XasWorks/XasCode/README.md

# XasCode allround libraries



This repository is constructed for all various libraries, be it made for OpenSCAD, AVR, or other systems, that are used for any XasWorks projects.

Currently included systems are:
- An OpenSCAD library
- An AVR Library for the ATMega328P or similar
