XasWorks/XasCode/ESP32/OneShot125/CMakeList.txt

idf_component_register(SRCS "BLDCHandler.cpp" "DShot.cpp" "OneShot125.cpp" "QuadrPropeller.cpp"
                       INCLUDE_DIRS "include")
