XasWorks/XasCode/(threads)

Thread 3 (2016-10-15):

Redo the Stepper-Motor (and some other) inheritance constructor calls.

Xasin, 2016-10-15:
Right now I'm just tricking the darn things by having a fake variable.
Ensure that they instead use constructors properly.

Xasin, 2016-10-16:
Checked:
The proper way of calling the constructor is by using
"ClassName(variables) : InheritedConstructorToBeUsed(variables) {
 }"

Simple!

Closed 2016-10-17.

Thread 16 (2017-07-17):

Improvement of the IR Code by use of ICP1 Capture Pin

Xasin, 2017-07-17:
By using the timestamp capture that the ICP1 pin provides, it would be possible to auto-adjust the timing of the IR receive ISR in order to automagically read in the data in the exact middle of the waveform.

- [x] The Timer1 ISR has to be adjusted to: OCR1A top, COMP1B_vect, so that ICR1 can still be used.
- [x] The INPUT_CAPTURE1_vect ISR has to be added
- [x] The state-machine has to be modified to remove the in-software waveform adjustment, and instead utilise the capture ISR for this.

@A-Bielefeld, I'm adding you to this so you can tag along with how these things get done >:D

Xasin, 2017-07-30:
Whelp, for now the code was moved to the LZRTag project exclusively, so it sort-of is closed ...
But an overhaul of this one here is presumably a good idea too.

Closed 2017-07-30.

Thread 32 (2019-10-23):

Fix awkward MQTT sub/pub behavior

Xasin, 2019-10-23:
Something is weird - the MQTT libraries seem to hang with their first connection for a while, before suddenly pushing out everything. Could be an artefact from not properly running the publish thread after a successful reconnect.

Xasin, 2019-10-29:
Push thread performance was improved by simply adding a "sleep" for automatic retries, and with the improved logging, debugging this should be perfectly fine!

Closed 2019-10-29.
