XasWorks/XasCode/AVR/Actuators/Steppers/X2Stepper.h

/*
 * X2Stepper.h
 *
 *  Created on: 24.10.2016
 *      Author: xasin
 */

#ifndef AVR_ACTUATORS_STEPPERS_X2STEPPER_H_
#define AVR_ACTUATORS_STEPPERS_X2STEPPER_H_

#include "PrimitiveStepper.h"
#include "../../Movement/X2/X2-Actuator.h"


namespace X2 {

class Stepper: private PrimitiveStepper, public Actuator {
private:
	// Constants for calculating how many steps the system has to do for forwards/backwards movement, as well as rotation.
	float const stepsPerMM, stepsPerDeg;

public:
	using PrimitiveStepper::update;

	// Main constructor, initializes values.
	Stepper(volatile uint8_t *P, uint8_t pins, uint8_t pind,
			uint16_t CPISR, float stepsPerMM, float stepsPerDeg);

	void ISRStepBy(float x, float r);
};

} /* namespace X2 */

#endif /* AVR_ACTUATORS_STEPPERS_X2STEPPER_H_ */
