XasWorks/XasCode/ESP32/XaI2C/LSM6DS3.cpp

/*
 * LSM6DS3.cpp
 *
 *  Created on: 1 May 2019
 *      Author: XNM
 */

#include "xnm/i2c/LSM6DS3.h"

#define LOG_LOCAL_LEVEL ESP_LOG_DEBUG
#include "esp_log.h"

namespace XNM {
namespace I2C {

LSM6DS3::LSM6DS3(uint8_t address)
	: 	maxGReading(0), maxDPSReading(0),
		axes(),
		isInitialized(false),
		addr(address) {

}

esp_err_t LSM6DS3::send_cmd(uint8_t cmd, uint8_t value) {
	auto i2c = MasterAction(addr);
	i2c.write(cmd, &value, 1);
	return i2c.execute();
}

#define CHECK_ERR(statement) do {auto r = statement; if(r != ESP_OK) {ret = r;}} while(false)
void LSM6DS3::init() {
	uint8_t FS_XLs[] = {0, 2, 3, 1};

	esp_err_t ret = ESP_OK;

	CHECK_ERR(send_cmd(CTRL1_XL, 0b01100011 | (FS_XLs[maxGReading] << 2)));

	CHECK_ERR(send_cmd(CTRL2_G, 0b01000000 | (maxDPSReading << 2)));
	CHECK_ERR(send_cmd(CTRL7_G, 0b01000000));	// Enable Highpass at 0.0324Hz

	CHECK_ERR(send_cmd(CTRL3, 0b00110100));	// INT pins Active Low & OD

	CHECK_ERR(send_cmd(CTRL10, 0b00111100));	// Enable extra functions

	CHECK_ERR(send_cmd(TAP_CFG, 0b00001111)); // Enable tap detection XYZ
	CHECK_ERR(send_cmd(TAP_THR, 0b001<<5 | 17));

	CHECK_ERR(send_cmd(0x5B, 0b1<<7));

	CHECK_ERR(send_cmd(0x5A, 0b00111111));

	if(ret != ESP_OK) {
		ESP_LOGE("LSM6DS3", "Failed to initialize %0X. Error: %s", addr, esp_err_to_name(ret));
	}
	else
		ESP_LOGI("LSM6DS3", "Finished init of %0X", addr);

	isInitialized = true;
}

float LSM6DS3::operator [](uint8_t id) {
	if(id >= 6)
		return 0;

	return axes[id];
}

void LSM6DS3::set_g_max(uint8_t num) {
	if(num == maxGReading)
		return;

	maxGReading = num;

	if(isInitialized) {
		uint8_t FS_XLs[] = {0, 2, 3, 1};
		send_cmd(CTRL1_XL, 0b01000011 | (FS_XLs[maxGReading] << 2));
	}
}

void LSM6DS3::set_dps_max(uint8_t num) {
	if(num == maxDPSReading)
		return;

	maxDPSReading = num;

	if(isInitialized)
		send_cmd(CTRL2_G, 0b01000000 | (maxDPSReading << 2));
}

void LSM6DS3::update() {
	int16_t bufferAxis[6] = {};

	auto i2c = MasterAction(addr);
	i2c.read(OUTX_L_G, bufferAxis, sizeof(bufferAxis));
	i2c.execute();

	float gMax[] = {2, 4, 8, 16};
	float DPSMax[] = {250, 500, 1000, 2000};
	
	for(uint8_t i=0; i<3; i++) {
		axes[i] = (bufferAxis[3+i]*gMax[maxGReading])/32767.0F;
		axes[3+i] = (bufferAxis[i]*DPSMax[maxDPSReading])/32767.0F;
	}
}

tap_src_t LSM6DS3::get_tap() {
	tap_src_t tap_reg = {};
	
	auto i2c = MasterAction(addr);
	i2c.read(TAP_SRC, &tap_reg, 1);
	i2c.execute();

	if(tap_reg.tapDetect || tap_reg.singleTap) {
		ESP_LOGD("LSM6DS3", "Tap data is: %c (Axis %d, dir %c, type %c)",
		tap_reg.tapDetect ? 'Y' : 'N', tap_reg.tapAxis, 
		tap_reg.tapDir ? '+' : '-', 
		tap_reg.doubleTap ? 'D' : 'S'
		);
	}

	return tap_reg;
}

} /* namespace I2C */
} /* namespace XNM */
