XasWorks/XasCode/STM32F4/NeoController/AnimationStep.cpp

/*
 * AnimationStep.cpp
 *
 *  Created on: 3 Mar 2020
 *      Author: xasin
 */

//
//AnimationStep::AnimationStep(const char *descriptor) {
//	auto first_id = AnimatorSource::decode_value_target(descriptor);
//	ID.uniq_id = first_id.ID.uniq_id;
//
//	if(ID.uniq_id == 0)
//		return;
//
//	const char * process_ptr = strpbrk(descriptor, ":");
//	if(process_ptr++ == nullptr)
//		return;
//	select_type(process_ptr);
//
//	for(int i=0; i<3; i++) {
//		process_ptr = strpbrk(process_ptr, ",");
//		if(process_ptr++ == nullptr)
//			return;
//		set_float_value(i, process_ptr);
//	}
//}
//
//void AnimationStep::select_type(const char *type_ptr) {
//	const char * const type_designators[] = {
//		"+",
//		"-",
//		"*",
//		"/",
//		"LIN",
//		"PT1",
//		"INT",
//		"DRV",
//		"MOD",
//		"TMR"
//	};
//
//	for(int i=0; i<MAX; i++) {
//		if(strstr(type_ptr, type_designators[i]) != nullptr) {
//			calc_type = static_cast<animator_operator_t>(i);
//			return;
//		}
//	}
//
//	calc_type = MAX;
//}
//
//void AnimationStep::set_float_value(uint8_t number, const char *description) {
//	if(number >= 3)
//		return;
//
//	data_ios[number].target_value = {};
//
//	if(strpbrk(description, "S")) {
//		data_ios[number].use_ptr = true;
//		data_ios[number].f_ptr = nullptr;
//
//		data_ios[number].target_value = decode_value_target(description);
//
//		needs_relink = true;
//	}
//	else {
//		data_ios[number].use_ptr = false;
//		data_ios[number].var = atof(description);
//	}
//}
