XasWorks/XasCode/(commit log)

2016-05-10 Final fixes, ensured compilability.
    [LFBasic.h, OmniwheelStepper.cpp, OmniwheelStepper.h, PrimitiveStepper.h, RotaryStepper.h, X3-Locomotor.cpp, X3-Locomotor.h]
2016-05-10 Added the basis for a TIMER0 Library.
2016-06-21 Added libraries for TIMER2 of the Mega328P
2016-09-27 Move of the Tagging from TRRIAN to XasCode
    [Tagging.scad]
2016-09-28 Code cleanup
    [Tagging.scad]
2016-09-28 Slight more code restructure & doc
    [Tagging.scad]
2016-09-28 Rendering was removed for functional coloring
    [Tagging.scad]
2016-09-29 Rendering-Optimisations and multi-tagging implementation
    [Tagging.scad]
2016-09-29 Fix for auto-render detection
    [Tagging.scad]
2016-10-15 Temporäre Fehlerbehebung durch deaktivation der TIMERX Bibliotheken.
2016-10-15 Start of some modifications to the TIMER, #2
2016-10-15 Stepper base class modification to allow for individual S/D pins
2016-10-17 Fixes #3, constructors are now properly called
    [OmniwheelStepper.cpp, RotaryStepper.cpp]
2016-10-18 Addition of TimerDefs.h header file This file contains all important register locations that may change over various chipsets. It also enables/disables the various timers, depending on their availabi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
    Closes #2
2016-10-24 Availability change to private & according changes, fixes #6
    [PrimitiveStepper.h, RotaryStepper.cpp]
2016-10-24 Addition of the X2 Stepper motor system.
2016-10-24 Kleiner Fix des Handling von pind
    [PrimitiveStepper.cpp]
2016-10-24 First commit for the new X2 Steppers
2016-10-24 Verkettung durch Base-Class "Actuator"
2016-10-25 Kleienr Fix (stepsToGo ist jetzt ja float)
    [PrimitiveStepper.cpp]
2016-10-25 Kleiner Fix für saubereres Laufen: stepBuffer=0
    [PrimitiveStepper.cpp]
2016-10-25 Fix der falschen "clamp"-Benutzung
    [X2-Movable.cpp]
2016-11-04 Implementation eines automatischen Battery-Guard
2016-11-06 Erstellung einer Status-LED-Klasse
    @fdcore, das könnte dir gefallen! :D
2016-12-15 Fix in the TimerDefs chip naming
    [Timer2.h, TimerDefs.h]
2016-12-17 Timer1 added CTC mode with auto Prescaler
2017-01-05 Set some battery values CONST
2017-01-05 Cast variable to 32bit to prevent overflow
    [Timer2.cpp]
2017-01-06 'Const'ing of other stepper classes
2017-01-30 Fix for bug found thanks to Codacy
    [ADC_Lib.cpp]
2017-02-04 Addition of a new analog-based LF sensor The new class LFA2Sens is designated for XasWorks/Notos#44
2017-02-04 Name refactor and sign-fix of offset calculation
    Class `LFA2Sens` was refactored to properly be called `ASens2`
    This lines up with the rest of the naming
    [LFA2Sens.cpp, LFA2Sens.h]
2017-02-11 Added Intersection-Detecting sensors.
2017-04-07 Added Timer1 mode for FPWM!
2017-04-07 Added Timer0 CTC Mode!
2017-04-11 Overriding the steps-to-go when it's <1 between steps LOOSES THEM!
    [PrimitiveStepper.cpp, PrimitiveStepper.h, X2-Movable.cpp]
2017-04-20 Added "movedBy" variable to keep track of stuff
2017-04-23 Enabled OC1B-Pin for TIMER1_FPWM
2017-09-12 Slight adjustments to temperature day path
2017-09-25 Added SocketError rescue, ensure qos>1 sending at_exit, slight failure improvements.
2018-06-13 Added rough callback button handling
2018-06-26 Added tests for track, wildcard and wait_for
2018-07-12 Fixed conversion by use of "if" instead of "case"
2018-08-27 Added timeout for UART coms
2018-08-27 Small fix for math derp
    [ESPUART.cpp, ESPUART.h]
2019-01-09 Began working on a LiPo battery class
2019-01-10 Added function to fetch charge percent from interpolatioN
2019-01-24 Switched to external I2S DAC
2019-01-30 Switched to multi-sound capable classes as containers
2019-01-30 Implemented capacity getters
2019-02-28 Smal fix to NeoController conversion code
    [NeoController.cpp]
2019-03-01 Began working on a driver for SSD1327
2019-03-19 Changed printf to ESP_LOG
2019-04-08 Inverted button output
2019-04-24 Added the MAX11613 4-Channel ADC
2019-05-01 Enabled Timer for ATmega168
2019-05-01 Added first library functions for LSM6DS3 gyro
2019-05-13 Added presence-detector to I2C Master Action
2019-05-15 Fixed the BME680 temp sensor
    [BME680.cpp]
2019-05-17 Fixed BME pressure reading
    [BME680.cpp]
2019-06-06 Changed AS1115 reset behavior
    [AS1115.cpp]
2019-06-13 Reworked a few audio ctrl parts for custom tone generation
    [NeoController.cpp]
2019-06-14 Began working on smooth square wave samples
2019-08-01 Small modifications to allow integer-divided sample playback
2019-08-10 Added a new base class to unify motor handling, added a DShot class
2019-08-27 Added an option for higher-power WiFi (noms up battery!)
2019-08-27 Added multi-channel DShot and minimum throttle value
2019-08-27 Added convenience functions to feed in and take out cJSON Makes it easier to program other adapters like UDP/TCP or MQTT sockets. Hell, even BT
2019-08-27 Added a small convenience wrapper for ESP32's HTTP client
2019-09-25 Add optional speed setting to I2C
    It just needed an option to externally specify the Baudrate, really
2019-09-25 Add error reporting when initializing the IMU
    Before, there was no way to tell when the IMU didn't initialize
    properly. A non-fatal error check was added
    [LSM6DS3.cpp]
2019-09-25 Prevent overflow by properly casting
    There was an issue with the multiplication due to the type of the
    colors. Casting fixes this
    [Color.cpp]
2019-10-06 Replace direct pub/sub with asynchronous packet queue
    The new system uses a separate thread that checks for connection status.
    With asynchronous packets it's much easier to deal with the timeouts
    that happen when publishing, while making application code highly
    responsive
2019-10-06 Implement the publishing thread
    The new system uses a thread-safe setup with packet queue for publishes
    and subscriptions. Timeouts and connection errors are handled
    asynchronously and with a proper capture, and packets are retried when
    connection is re-established
2020-02-02 Add a XasWorks KiCAD library of footprints
2020-02-03 Moved PCB footprint folders
2020-02-27 Add libraries for the STM32F4 chip (LEDs <3)
2020-03-15 Fix the AnimationStep calculation
    [AnimationStep.cpp]
2020-03-15 Add an Invert option to NeoPixel
    [NeoController.cpp, NeoController.h]
2020-10-30 Add extra KiCAD footprints
2021-02-09 Add additional footprints
2021-02-26 Fix a few KiCAD Footprint issues
2021-03-17 Add temperature color generation
2021-05-06 Add better colour temperature conversion
2021-05-06 Add the LT303ALS Ambient Light Sensor
2021-05-19 Add powersave option to NVS WiFi Setup
2021-06-08 Tweak audio code (reduce TX Jitter)
2021-06-21 Tweak type of battery table
2021-06-21 Add basic DRV2605 vibration motor code
    [DRV2605.cpp]
2021-08-01 Add new footprints
2021-08-30 Adjust MQTT printf to avoid recursive errors
    [net_helpers.cpp]
2021-08-30 Begin work on a cleaner OTA flow
2021-08-30 Add mounting holes for 1.5mm screw
2021-09-15 Continue work on fixing incessant MQTT glitch
    [MQTTOutput.cpp, net_helpers.cpp, ota.cpp]
2021-09-28 Adjust 1.5mm mount hole tolerance
2021-10-15 Modify ESP32 code for IDF Version 4.3.1
2021-11-17 Tweak NeoController to avoid output glitching
    [NeoController.cpp, NeoController.h]
2021-12-03 Add necessary KiCAD footprints
2021-12-03 Swap namespace to fit new, more accurate convention
    [AS1115.cpp, AW9201.cpp, BME680.cpp, DRV2605.cpp]
2021-12-03 Update LittleOLED to use new I2C convention
2022-01-01 Add UART based PropertyPoint configurator
